jeffkub/esp32-galvo/README.md

# esp32-galvo
Laser galvo controller board using the ESP32.

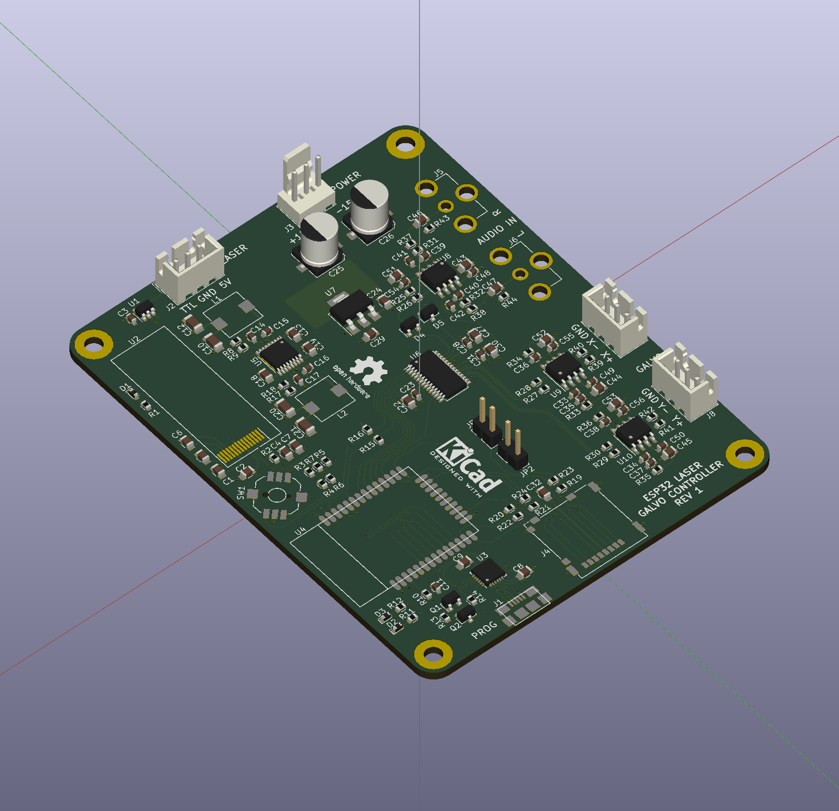
[picture p1: pictures/galvo_controller_3d.png]
