jeffkub/esp32-galvo/hardware/galvo_controller/galvo_controller.pdf

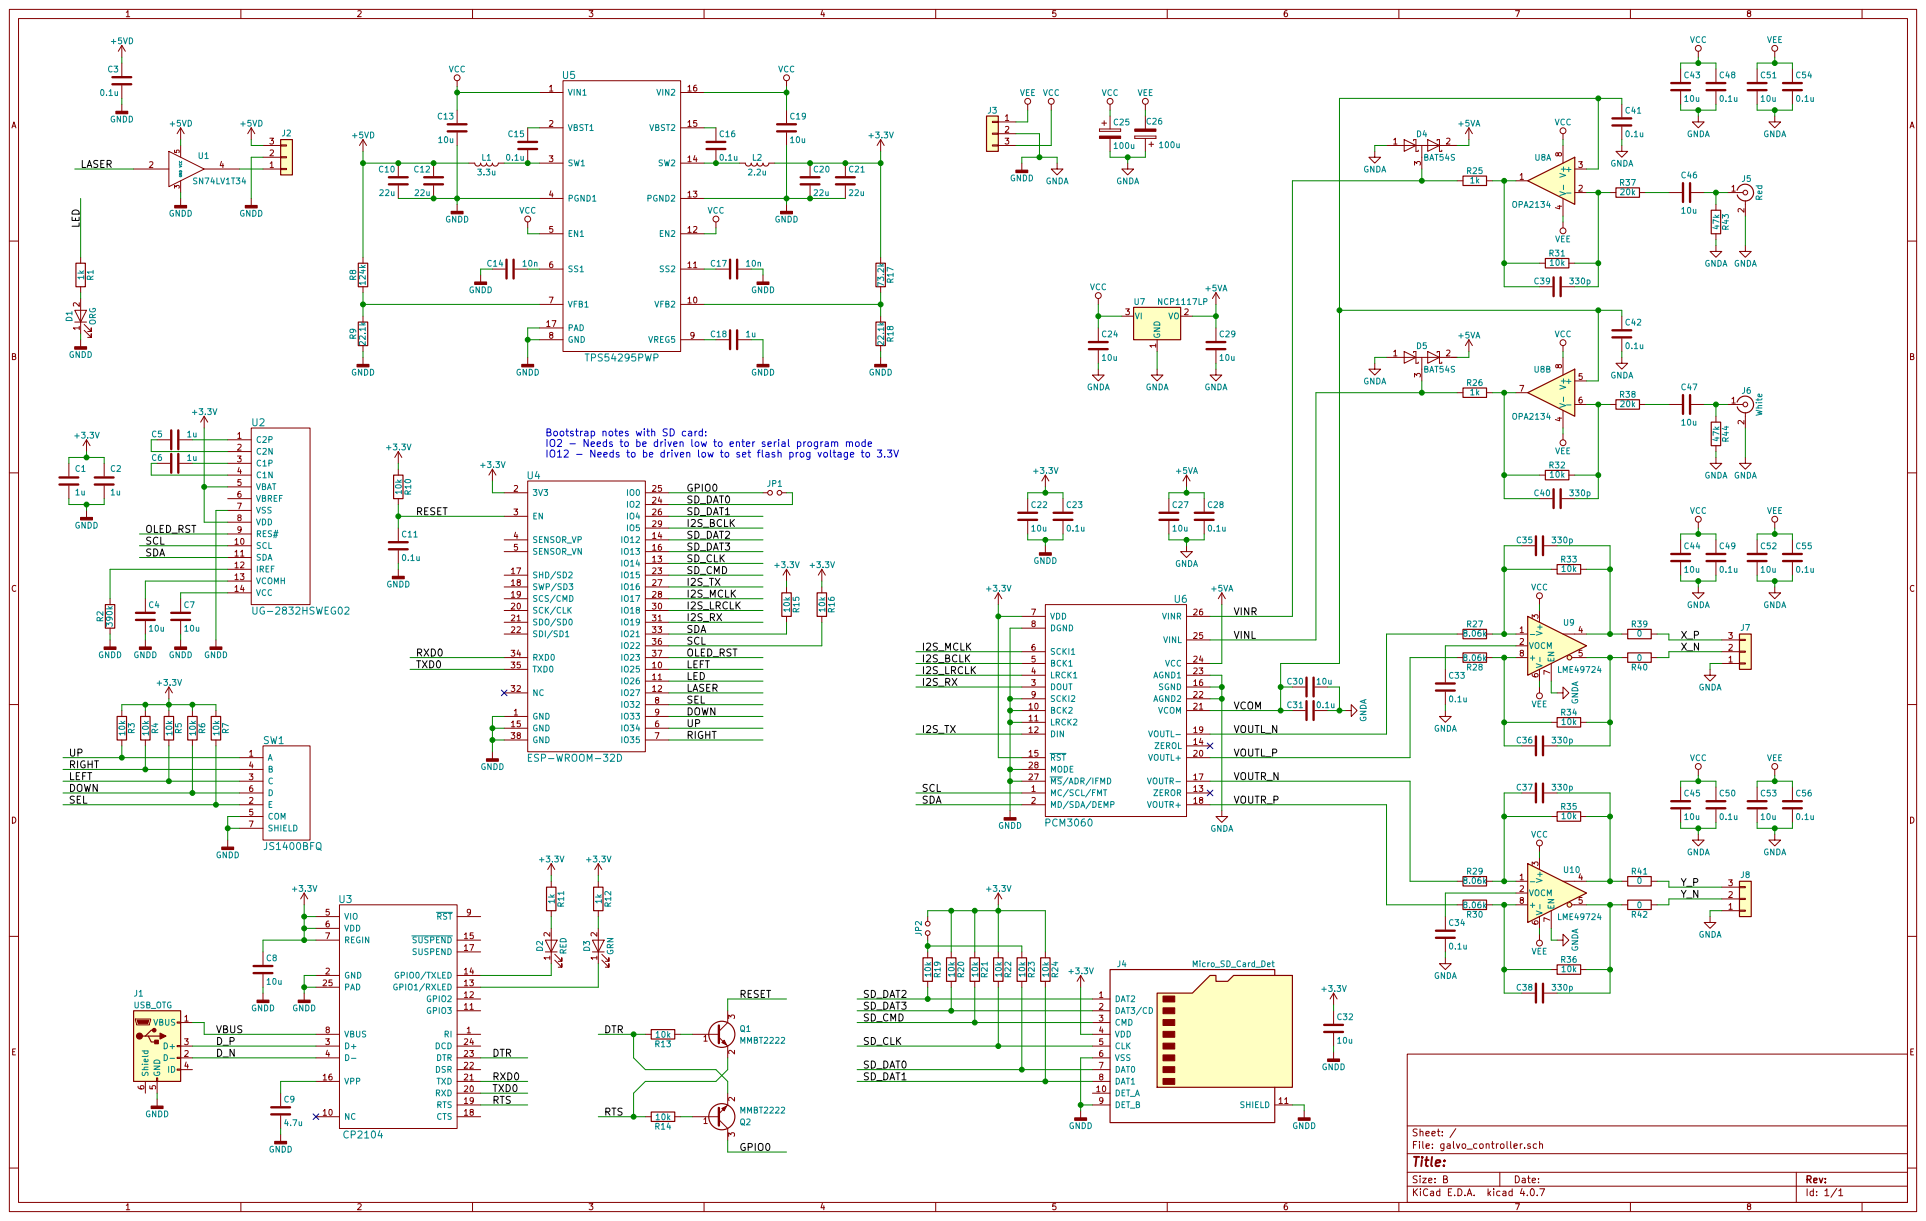
[picture p2: page 1]
