jeffkub/esp32-galvo/hardware/galvo_controller/galvo_controller.kicad_pcb

## KiCad design hardware/galvo_controller/galvo_controller.kicad_pcb (2018-03-18)

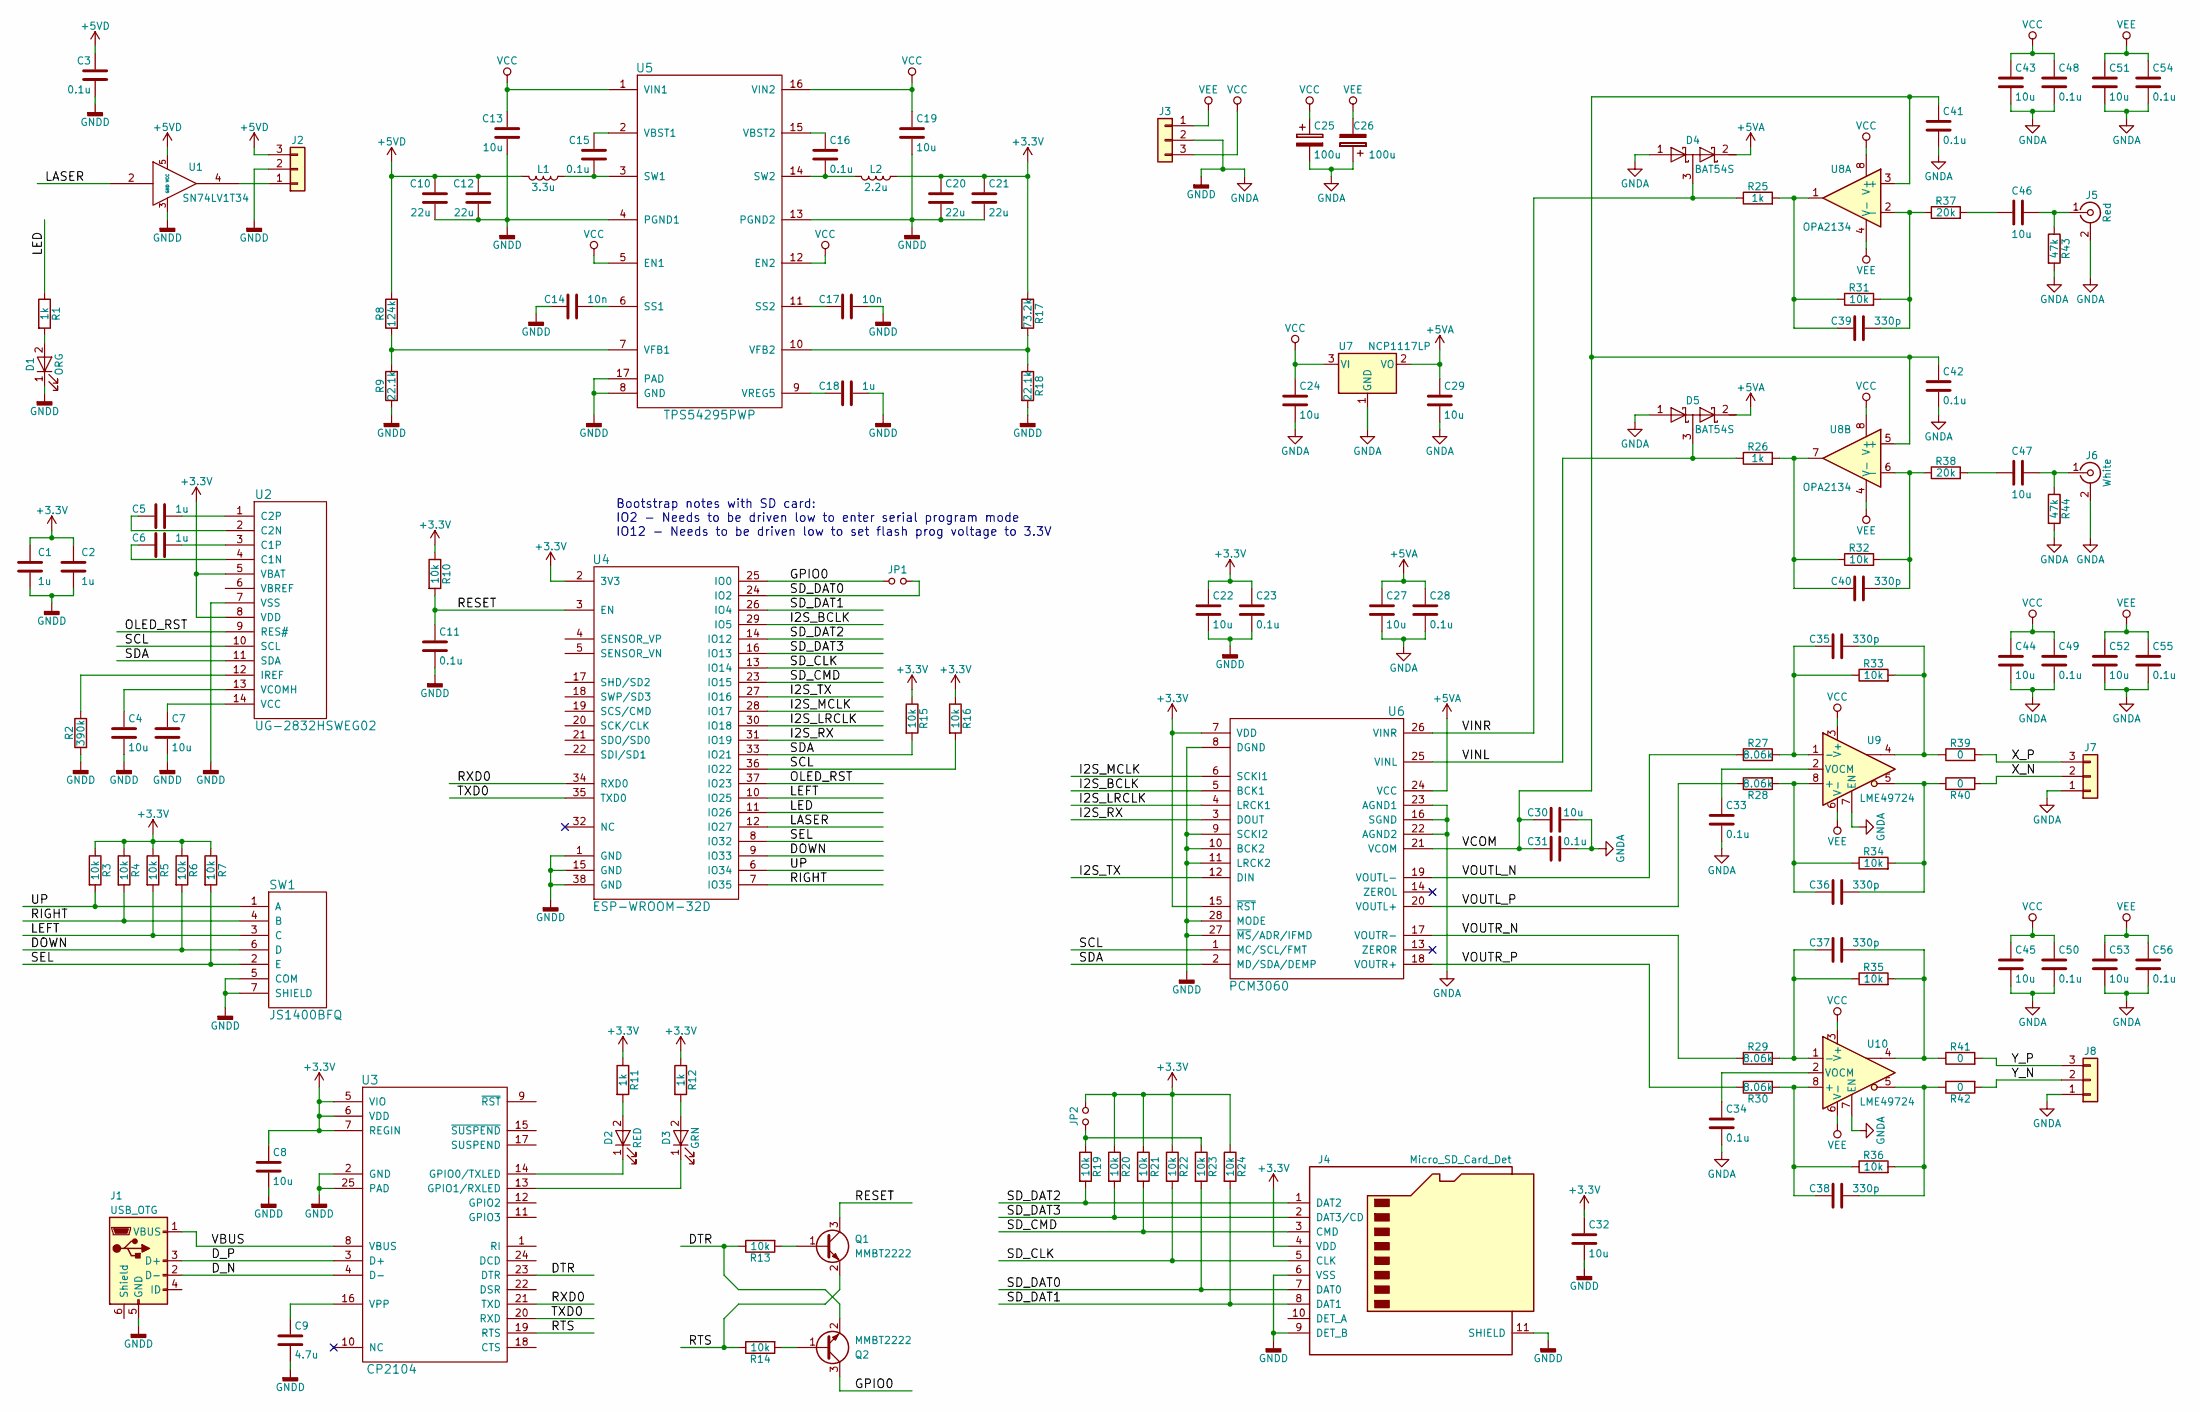
[picture p3: schematic galvo_controller.sch]

Parts:
C1, C2, C5, C6, C18: 1u; C_0805; Part 490-1691-1-ND
C3, C11, C15, C16, C23, C28, C31, C33, C34, C41, C42, C48, C49, C50, C54, C55, C56: 0.1u; C_0603; Part 490-9691-1-ND
C4, C7, C8, C13, C19, C22, C24, C27, C29, C30, C32, C43, C44, C45, C46, C47, C51, C52, C53: 10u; C_0805; Part 490-5523-1-ND
C9: 4.7u; C_0805; Part 490-5422-1-ND
C10, C12, C20, C21: 22u; C_1206; Part 490-6509-1-ND
C14, C17: 10n; C_0603; Part 490-9734-1-ND
C25, C26: 100u; CP_Elec_6.3x7.7; Part PCE3951CT-ND
C35, C36, C37, C38, C39, C40: 330p; C_0603; Part 490-11460-1-ND
D1: ORG; D_0603; Part 160-1434-1-ND
D2: RED; D_0603; Part 160-1447-1-ND
D3: GRN; D_0603; Part 160-1435-1-ND
D4, D5: BAT54S; SOT-23; Part BAT54S-FDICT-ND
J1: USB_OTG; 10118192; Part 609-4613-1-ND
J2, J7, J8: Conn_01x03; JST_XH_B03B-XH-A_03x2.50mm_Straight; Part 455-2248-ND
J3: Conn_01x03; Molex_KK-6410-03_03x2.54mm_Straight; Part WM4201-ND
J4: Micro_SD_Card_Det; 503182-1853; Part WM9750CT-ND
J5: Red; RCJ-01x; Part CP-1401-ND
J6: White; RCJ-01x; Part CP-1402-ND
JP1, JP2: Jumper_NO_Small; Pin_Header_Straight_1x02_Pitch2.54mm; Part 3M9457-02-ND
L1: 3.3u; CLF7045-D; Part 445-9554-1-ND
L2: 2.2u; CLF7045-D; Part 445-9553-1-ND
Q1, Q2: MMBT2222; SOT-23; Part MMBT2222ALT3GOSCT-ND
R1, R11, R12, R25, R26: 1k; R_0603; Part 311-1.00KHRCT-ND
R2: 390k; R_0603; Part 311-390KHRCT-ND
R3, R4, R5, R6, R7, R10, R13, R14, R15, R16, R19, R20, R21, R22, R23, R24, R31, R32, R33, R34, R35, R36: 10k; R_0603; Part 311-10.0KHRCT-ND
R8: 124k; R_0603; Part 311-124KHRCT-ND
R9, R18: 22.1k; R_0603; Part 311-22.1KHRCT-ND
R17: 73.2k; R_0603; Part 311-73.2KHRCT-ND
R27, R28, R29, R30: 8.06k; R_0603; Part 311-8.06KHRCT-ND
R37, R38: 20k; R_0603; Part 311-20.0KHRCT-ND
R39, R40, R41, R42: 0; R_0603; Part 311-0.0GRCT-ND
R43, R44: 47k; R_0603; Part 311-47.0KHRCT-ND
SW1: JS1400BFQ; Part 612-JS1400BFQ
U1: SN74LV1T34; SOT-23-5; Part 296-37176-1-ND
U2: UG-2832HSWEG02; Part UG-2832HSWEG02
U3: CP2104; QFN-24-1EP_4x4mm_Pitch0.5mm; Part 336-2008-5-ND
U4: ESP-WROOM-32D; ESP32-WROOM; Part 1528-1801-ND
U5: TPS54295PWP; HTSSOP-16-1EP_4.4x5mm_Pitch0.65mm_ThermalVias; Part 296-29960-1-ND
U6: PCM3060
U7: NCP1117LP; SOT-223-3_TabPin2; Part NCP1117LPST50T3GOSCT-ND
U8: OPA2134; SOIC-8_3.9x4.9mm_Pitch1.27mm; Part 296-22024-1-ND
U9, U10: LME49724; SOIC-8-1EP_3.9x4.9mm_Pitch1.27mm; Part 296-37390-1-ND

Connections:
+3V3: C1.2, C2.2, C8.1, C20.1, C21.1, C22.1, C23.1, C32.1, J4.4 (VDD), JP2.2, L2.1, R3.1, R4.1, R5.1, R6.1, R7.1, R10.1, R11.1, R12.1, R15.1, R16.1, R17.1, R20.1, R21.1, R22.1, R24.1, U2.5 (VBAT), U2.8 (VDD), U3.5 (VIO), U3.6 (VDD), U3.7 (REGIN), U4.2 (3V3), U6.7 (VDD), U6.15 (~RST)
+5VA: C27.1, C28.1, C29.1, D4.2 (K), D5.2 (K), U6.24 (VCC), U7.2 (VO)
+5VD: C3.1, C10.1, C12.1, J2.3, L1.2, R8.1, U1.5 (VCC)
/DOWN: R6.2, SW1.6 (D), U4.9 (IO33)
/DTR: Q2.2 (E), R13.1, U3.23 (DTR)
/D_N: J1.2 (D-), U3.4 (D-)
/D_P: J1.3 (D+), U3.3 (D+)
/GPIO0: JP1.1, Q2.3 (C), U4.25 (IO0)
/I2S_BCLK: U4.29 (IO5), U6.5 (BCK1)
/I2S_LRCLK: U4.30 (IO18), U6.4 (LRCK1)
/I2S_MCLK: U4.28 (IO17), U6.6 (SCKI1)
/I2S_RX: U4.31 (IO19), U6.3 (DOUT)
/I2S_TX: U4.27 (IO16), U6.12 (DIN)
/LASER: U1.2, U4.12 (IO27)
/LED: R1.1, U4.11 (IO26)
/LEFT: R5.2, SW1.3 (C), U4.10 (IO25)
/OLED_RST: U2.9 (RES#), U4.37 (IO23)
/RESET: C11.1, Q1.3 (C), R10.2, U4.3 (EN)
/RIGHT: R4.2, SW1.4 (B), U4.7 (IO35)
/RTS: Q1.2 (E), R14.1, U3.19 (RTS)
/RXD0: U3.21 (TXD), U4.34 (RXD0)
/SCL: R16.2, U2.10 (SCL), U4.36 (IO22), U6.1 (MC/SCL/FMT)
/SDA: R15.2, U2.11 (SDA), U4.33 (IO21), U6.2 (MD/SDA/DEMP)
/SD_CLK: J4.5 (CLK), R22.2, U4.13 (IO14)
/SD_CMD: J4.3 (CMD), R21.2, U4.23 (IO15)
/SD_DAT0: J4.7 (DAT0), JP1.2, R23.2, U4.24 (IO2)
/SD_DAT1: J4.8 (DAT1), R24.2, U4.26 (IO4)
/SD_DAT2: J4.1 (DAT2), R19.2, U4.14 (IO12)
/SD_DAT3: J4.2 (DAT3/CD), R20.2, U4.16 (IO13)
/SEL: R7.2, SW1.2 (E), U4.8 (IO32)
/TXD0: U3.20 (RXD), U4.35 (TXD0)
/UP: R3.2, SW1.1 (A), U4.6 (IO34)
/VBUS: J1.1 (VBUS), U3.8 (VBUS)
/VCOM: C30.2, C31.2, C41.1, C42.1, U6.21 (VCOM), U8.3 (+), U8.5 (+)
/VINL: D5.3 (common), R26.1, U6.25 (VINL)
/VINR: D4.3 (common), R25.1, U6.26 (VINR)
/VOUTL_N: R27.1, U6.19 (VOUTL-)
/VOUTL_P: R28.1, U6.20 (VOUTL+)
/VOUTR_N: R29.1, U6.17 (VOUTR-)
/VOUTR_P: R30.1, U6.18 (VOUTR+)
/X_N: J7.2, R40.2
/X_P: J7.3, R39.2
/Y_N: J8.2, R42.2
/Y_P: J8.3, R41.2
GNDA: C1.1, C2.1, C3.2, C4.2, C7.2, C8.2, C9.2, C10.2, C11.2, C12.2, C13.2, C14.2, C17.1, C18.1, C19.2, C20.2, C21.2, C22.2, C23.2, C24.2, C25.2, C26.1, C27.2, C28.2, C29.2, C30.1, C31.1, C32.2, C33.2, C34.2, C41.2, C42.2, C43.2, C44.2, C45.2, C48.2, C49.2, C50.2, C51.2, C52.2, C53.2, C54.2, C55.2, C56.2, D1.1 (K), D4.1 (A), D5.1 (A), J1.5 (GND), J2.2, J3.2, J4.6 (VSS), J4.9 (DET_B), J4.11 (SHIELD), J5.2 (Ext), J6.2 (Ext), J7.1, J8.1, R2.2, R9.2, R18.2, R43.2, R44.2, SW1.5 (COM), SW1.7 (SHIELD), U1.3 (GND), U2.7 (VSS), U3.2 (GND), U3.25 (PAD), U4.1 (GND), U4.15 (GND), U4.38 (GND), U5.4 (PGND1), U5.8 (GND), U5.13 (PGND2), U5.17 (PAD), U6.8 (DGND), U6.9 (SCKI2), U6.10 (BCK2), U6.11 (LRCK2), U6.16 (SGND), U6.22 (AGND2), U6.23 (AGND1), U6.27 (~MS~/ADR/IFMD), U6.28 (MODE), U7.1 (GND), U9.7 (EN), U10.7 (EN)
unnamed: C4.1, U2.13 (VCOMH)
unnamed: C5.1, U2.1 (C2P)
unnamed: C5.2, U2.2 (C2N)
unnamed: C6.1, U2.3 (C1P)
unnamed: C6.2, U2.4 (C1N)
unnamed: C7.1, U2.14 (VCC)
unnamed: C9.1, U3.16 (VPP)
unnamed: C14.1, U5.6 (SS1)
unnamed: C15.1, U5.2 (VBST1)
unnamed: C15.2, L1.1, U5.3 (SW1)
unnamed: C16.1, U5.15 (VBST2)
unnamed: C16.2, L2.2, U5.14 (SW2)
unnamed: C17.2, U5.11 (SS2)
unnamed: C18.2, U5.9 (VREG5)
unnamed: C33.1, U9.2 (VOCM)
unnamed: C34.1, U10.2 (VOCM)
unnamed: C35.1, R33.2, R39.1, U9.4
unnamed: C35.2, R27.2, R33.1, U9.1 (-)
unnamed: C36.1, R34.2, R40.1, U9.5
unnamed: C36.2, R28.2, R34.1, U9.8 (+)
unnamed: C37.1, R35.2, R41.1, U10.4
unnamed: C37.2, R29.2, R35.1, U10.1 (-)
unnamed: C38.1, R36.2, R42.1, U10.5
unnamed: C38.2, R30.2, R36.1, U10.8 (+)
unnamed: C39.1, R31.2, R37.1, U8.2 (-)
unnamed: C39.2, R25.2, R31.1, U8.1
unnamed: C40.1, R32.2, R38.1, U8.6 (-)
unnamed: C40.2, R26.2, R32.1, U8.7
unnamed: C46.1, J5.1 (In), R43.1
unnamed: C46.2, R37.2
unnamed: C47.1, J6.1 (In), R44.1
unnamed: C47.2, R38.2
unnamed: D1.2 (A), R1.2
unnamed: D2.1 (K), U3.14 (GPIO0/TXLED)
unnamed: D2.2 (A), R11.2
unnamed: D3.1 (K), U3.13 (GPIO1/RXLED)
unnamed: D3.2 (A), R12.2
unnamed: J2.1, U1.4
unnamed: JP2.1, R19.1, R23.1
unnamed: Q1.1 (B), R13.2
unnamed: Q2.1 (B), R14.2
unnamed: R2.1, U2.12 (IREF)
unnamed: R8.2, R9.1, U5.7 (VFB1)
unnamed: R17.2, R18.1, U5.10 (VFB2)
VCC: C13.1, C19.1, C24.1, C25.1, C43.1, C44.1, C45.1, C48.1, C49.1, C50.1, J3.3, U5.1 (VIN1), U5.5 (EN1), U5.12 (EN2), U5.16 (VIN2), U7.3 (VI), U8.8 (V+), U9.3 (V+), U10.3 (V+)
VEE: C26.2, C51.1, C52.1, C53.1, C54.1, C55.1, C56.1, J3.1, U8.4 (V-), U9.6 (V-), U9.9 (V-), U10.6 (V-), U10.9 (V-)

Notes on the sheet:
Bootstrap notes with SD card: IO2 - Needs to be driven low to enter serial program mode IO12 - Needs to be driven low to set flash prog voltage to 3.3V

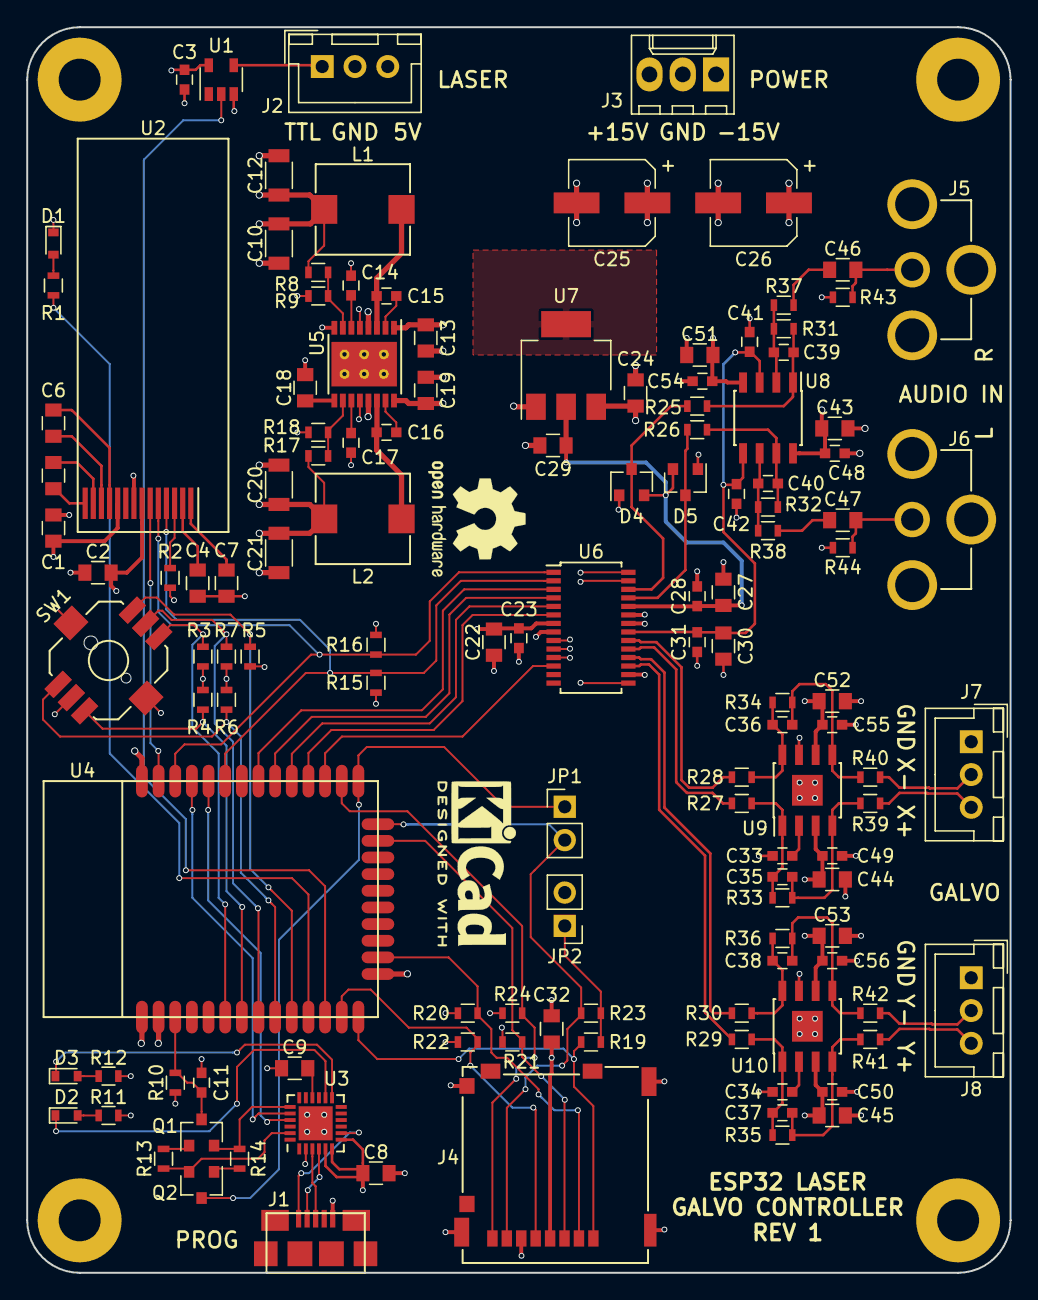
[picture p4: board galvo_controller.kicad_pcb from above]

Board: 4 copper layers, 75.0 x 95.0 mm, 130 parts (0 on the bottom side), 91 nets.
