jeffkub/esp32-galvo/(commit log)

2018-03-08 Renamed kicad project
    [galvo_controller.kicad_pcb, galvo_controller.sch, galvo_driver.sch]
2018-03-08 Working on schematic
    [galvo_controller.sch]
2018-03-10 Switched to ESP32 microcontroller
    [galvo_controller.sch]
2018-03-10 Using switching regulator for 3.3V and 5V rails
    [galvo_controller.sch]
2018-03-10 Changed to single buck DC DC converter
    [galvo_controller.sch]
2018-03-11 Working on footprints
    [galvo_controller.sch]
2018-03-11 Finished BOM, exported to layout
    [galvo_controller.kicad_pcb, galvo_controller.sch]
2018-03-11 Working on component placement
    [galvo_controller.kicad_pcb]
2018-03-12 Working on layout
    [galvo_controller.kicad_pcb, galvo_controller.sch]
2018-03-12 Switched to logic buffer for laser enable
    [galvo_controller.kicad_pcb, galvo_controller.sch]
2018-03-13 Tweaked SD card pullup jumpers
    [galvo_controller.kicad_pcb, galvo_controller.sch]
2018-03-14 Added oled display
    [galvo_controller.kicad_pcb, galvo_controller.sch]
2018-03-14 Adding directional switch
    [galvo_controller.kicad_pcb, galvo_controller.sch]
2018-03-14 Added oled display (reverted from commit 7e9d64baadf71845b197ee83ec8b18551d687449)
    [galvo_controller.kicad_pcb, galvo_controller.sch]
2018-03-14 Restored footprints/ symbols for OLED and nav switch
2018-03-14 Swapped input L/R channels
    [galvo_controller.kicad_pcb, galvo_controller.sch]
2018-03-14 Created symbol and footprint for directional switch
2018-03-15 Added OLED and nav switch
    [galvo_controller.kicad_pcb, galvo_controller.sch]
2018-03-15 Re-annotated schematic
    [galvo_controller.kicad_pcb, galvo_controller.sch]
2018-03-16 Finished routing board
    [galvo_controller.kicad_pcb, galvo_controller.sch]
2018-03-16 Adjusted oled footprint
    [galvo_controller.kicad_pcb]
2018-03-16 Adding silkscreen text
    [galvo_controller.kicad_pcb]
2018-03-17 Cleaned up reference designators, finalizing layout
    [galvo_controller.kicad_pcb]
2018-03-17 Added kicad-libs as a git submodule
2018-03-17 Moved footprints and symbols into git submodule
    [galvo_controller.sch]
2018-03-17 Changed power connector. Added symbols
    [galvo_controller.kicad_pcb, galvo_controller.sch]
2018-03-17 Fixed connector pinouts, working on silkscreen layers
    [galvo_controller.kicad_pcb, galvo_controller.sch]
2018-03-17 Minor PCB tweaks
    [galvo_controller.kicad_pcb]
2018-03-17 Exported gerbers
    [galvo_controller.kicad_pcb]
2018-03-18 Tweaked solder mask and paste settings
    [galvo_controller.kicad_pcb]
2018-03-18 Fixed missing part number on BOM
    [galvo_controller.sch]
